ErPeris/PC/Scheda_Test_Arduino/Scheda_Test_Arduino.pdf

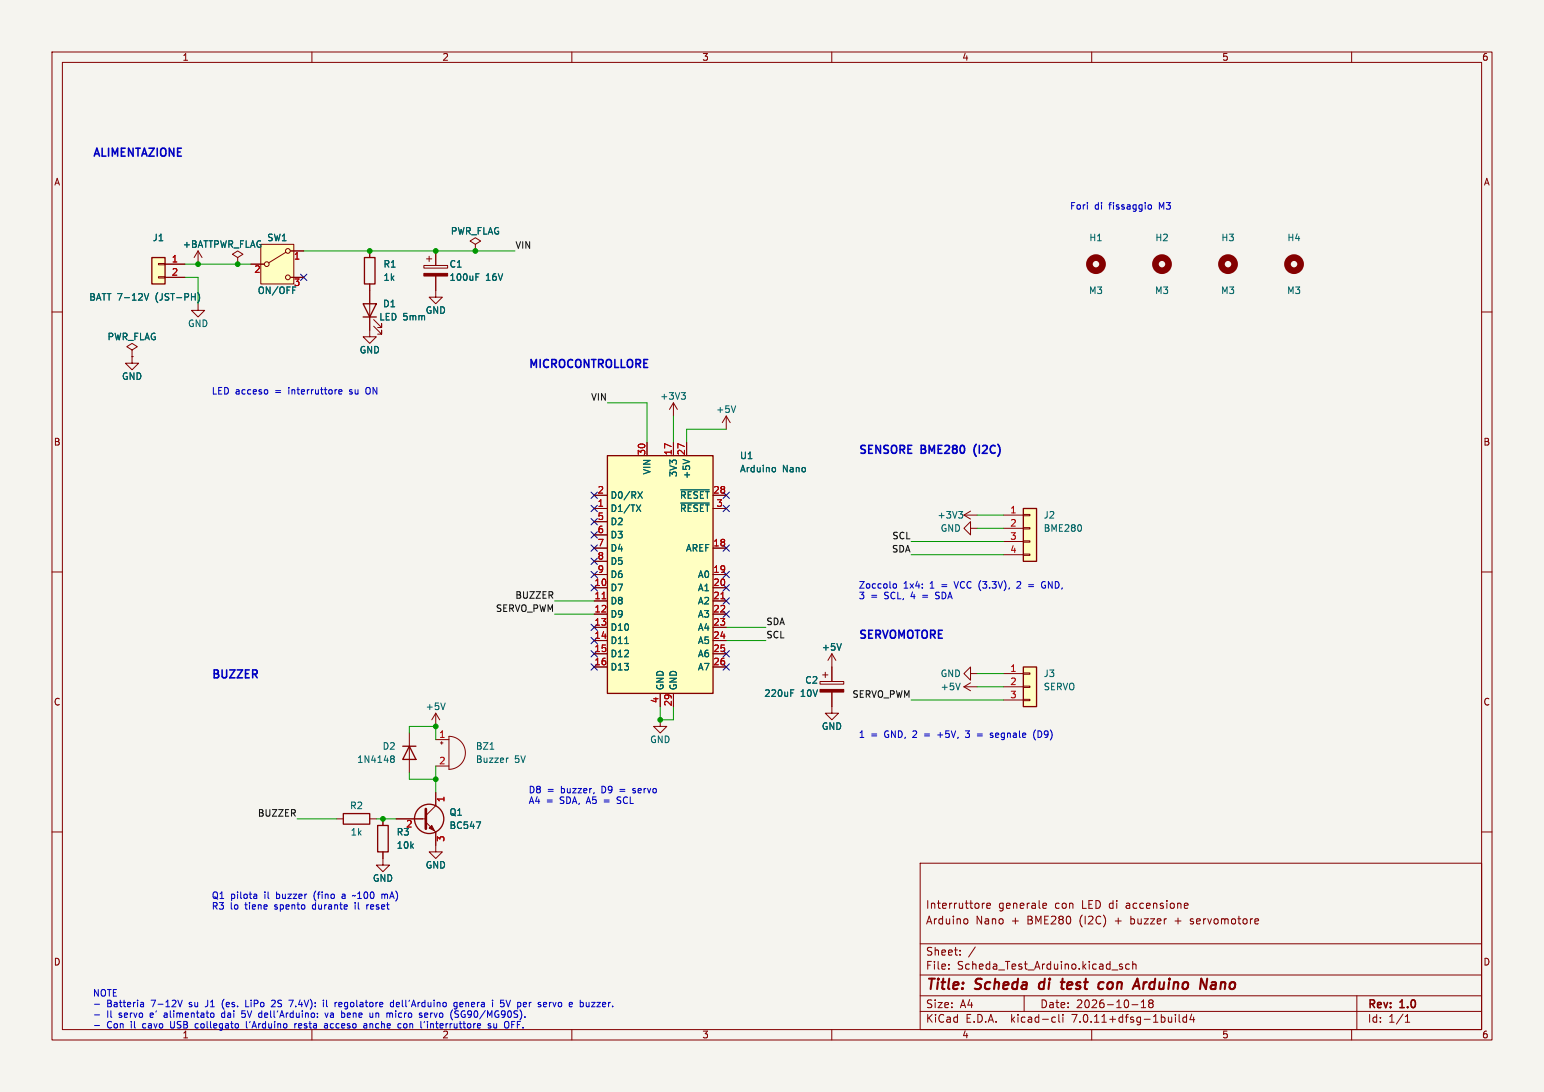
[picture p1: page 1]

Zoccolo 1x4: 1 = VCC (3.3V), 2 = GND, 3 = SCL, 4 = SDA

D8 = buzzer, D9 = servo A4 = SDA, A5 = SCL BUZZER

Q1 pilota il buzzer (fino a ~100 mA) R3 lo tiene spento durante il reset NOTE

Id: 1/1 Title: Scheda di test con Arduino Nano
