ErPeris/PC/Scheda_Test_Arduino/Scheda_Test_Arduino_PCB.pdf

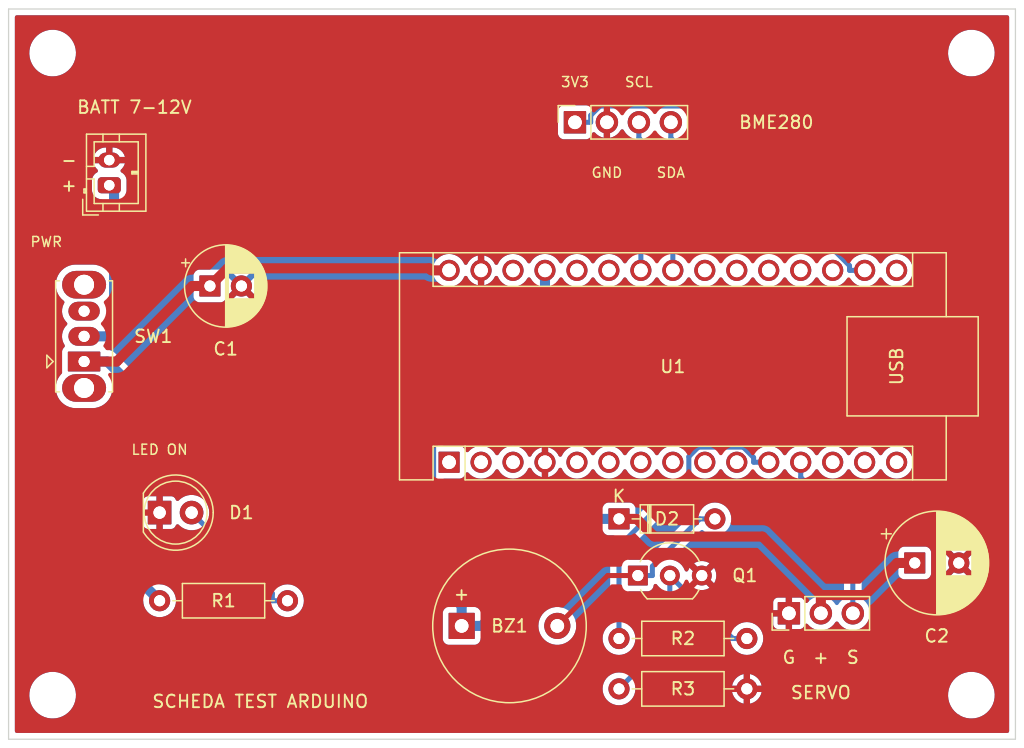
[picture p2: page 1]

SERVO SCHEDA TEST ARDUINO
