ErPeris/PC/Variante_A_LDO/Servo_Driver_A_LDO.pdf

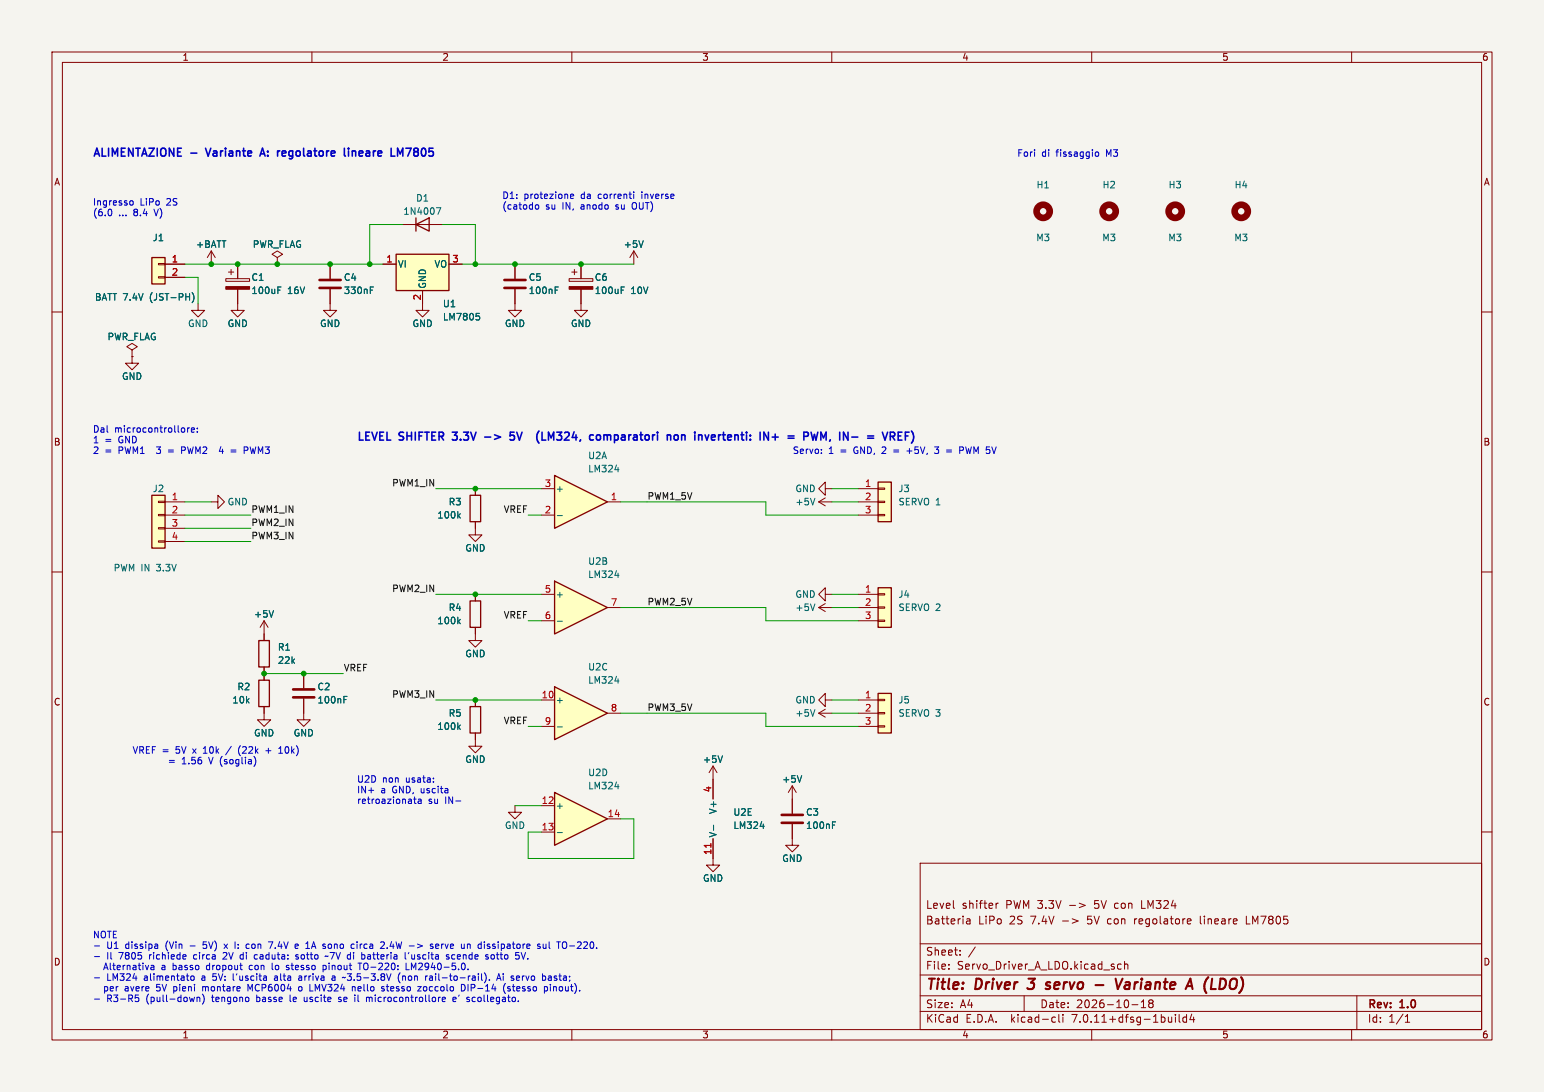
[picture p3: page 1]
