ErPeris/PC/Variante_A_LDO/Servo_Driver_A_LDO_PCB.pdf

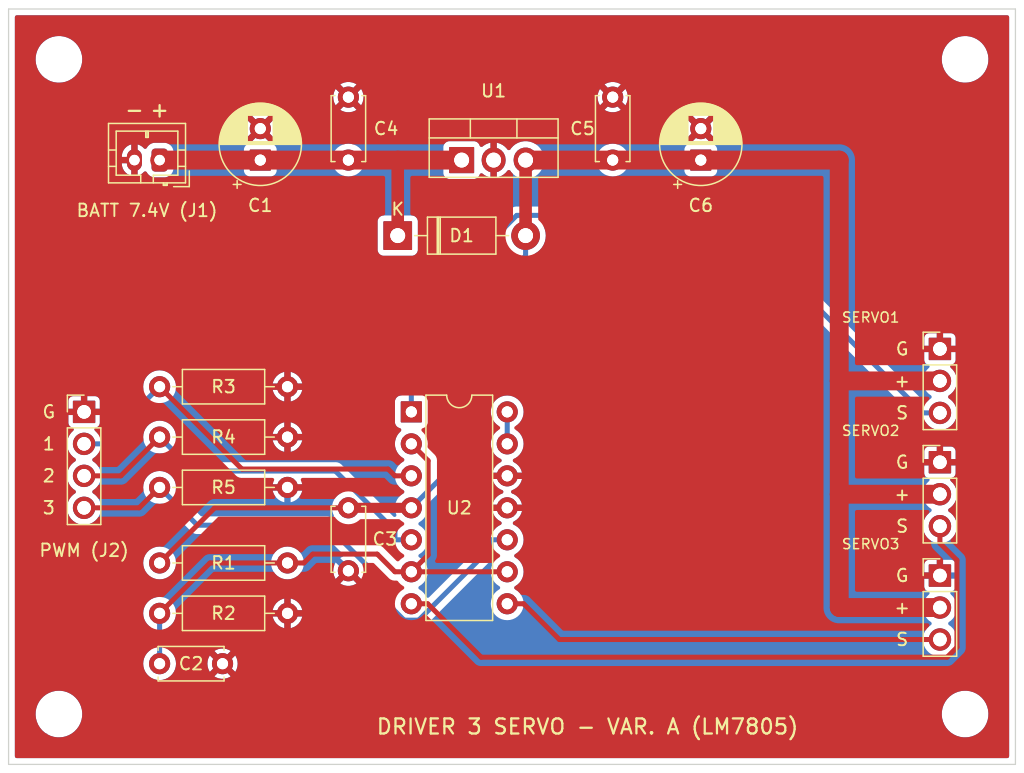
[picture p4: page 1]
