ErPeris/PC/Variante_B_Buck/Servo_Driver_B_Buck.pdf

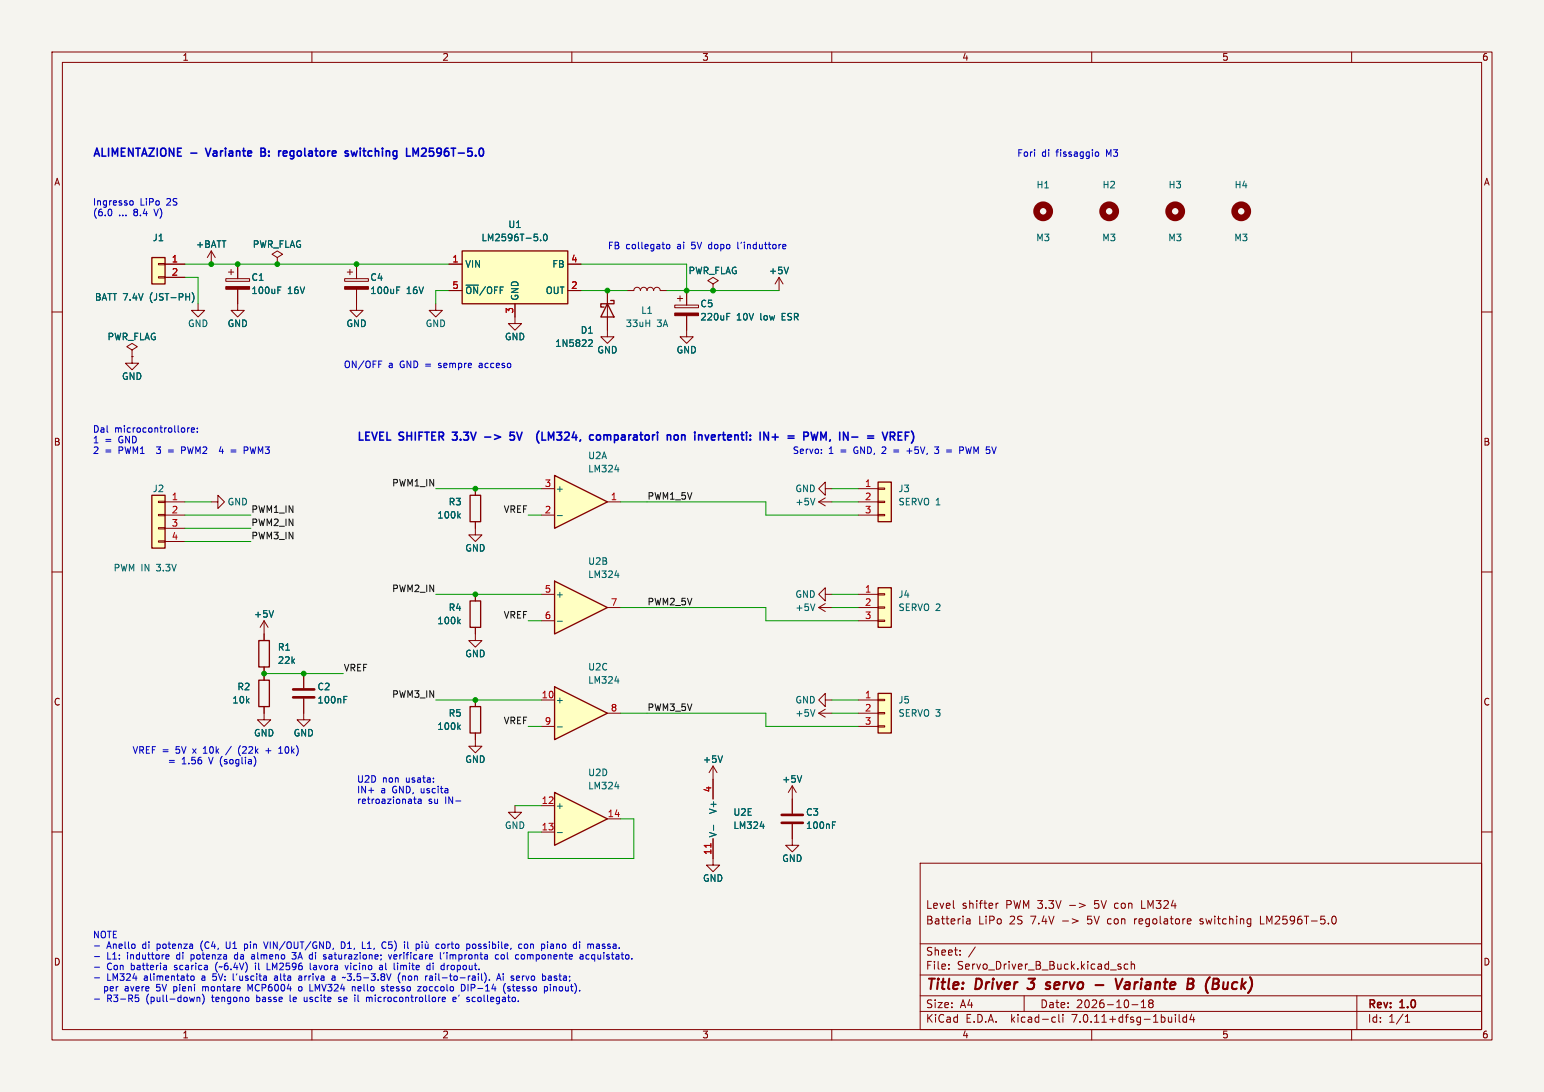
[picture p5: page 1]
