ErPeris/PC/Variante_B_Buck/Servo_Driver_B_Buck_PCB.pdf

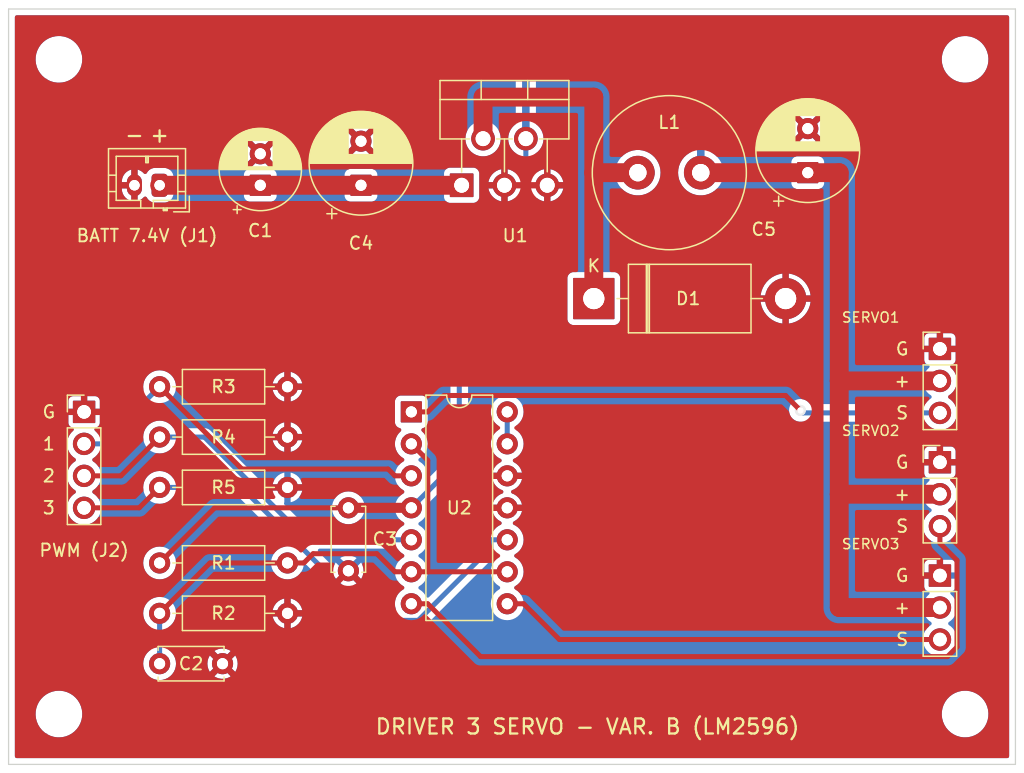
[picture p6: page 1]
