ErPeris/PC/Scheda_Test_Arduino/Scheda_Test_Arduino.kicad_pcb

## KiCad design Scheda_Test_Arduino/Scheda_Test_Arduino.kicad_pcb (2026-10-18)

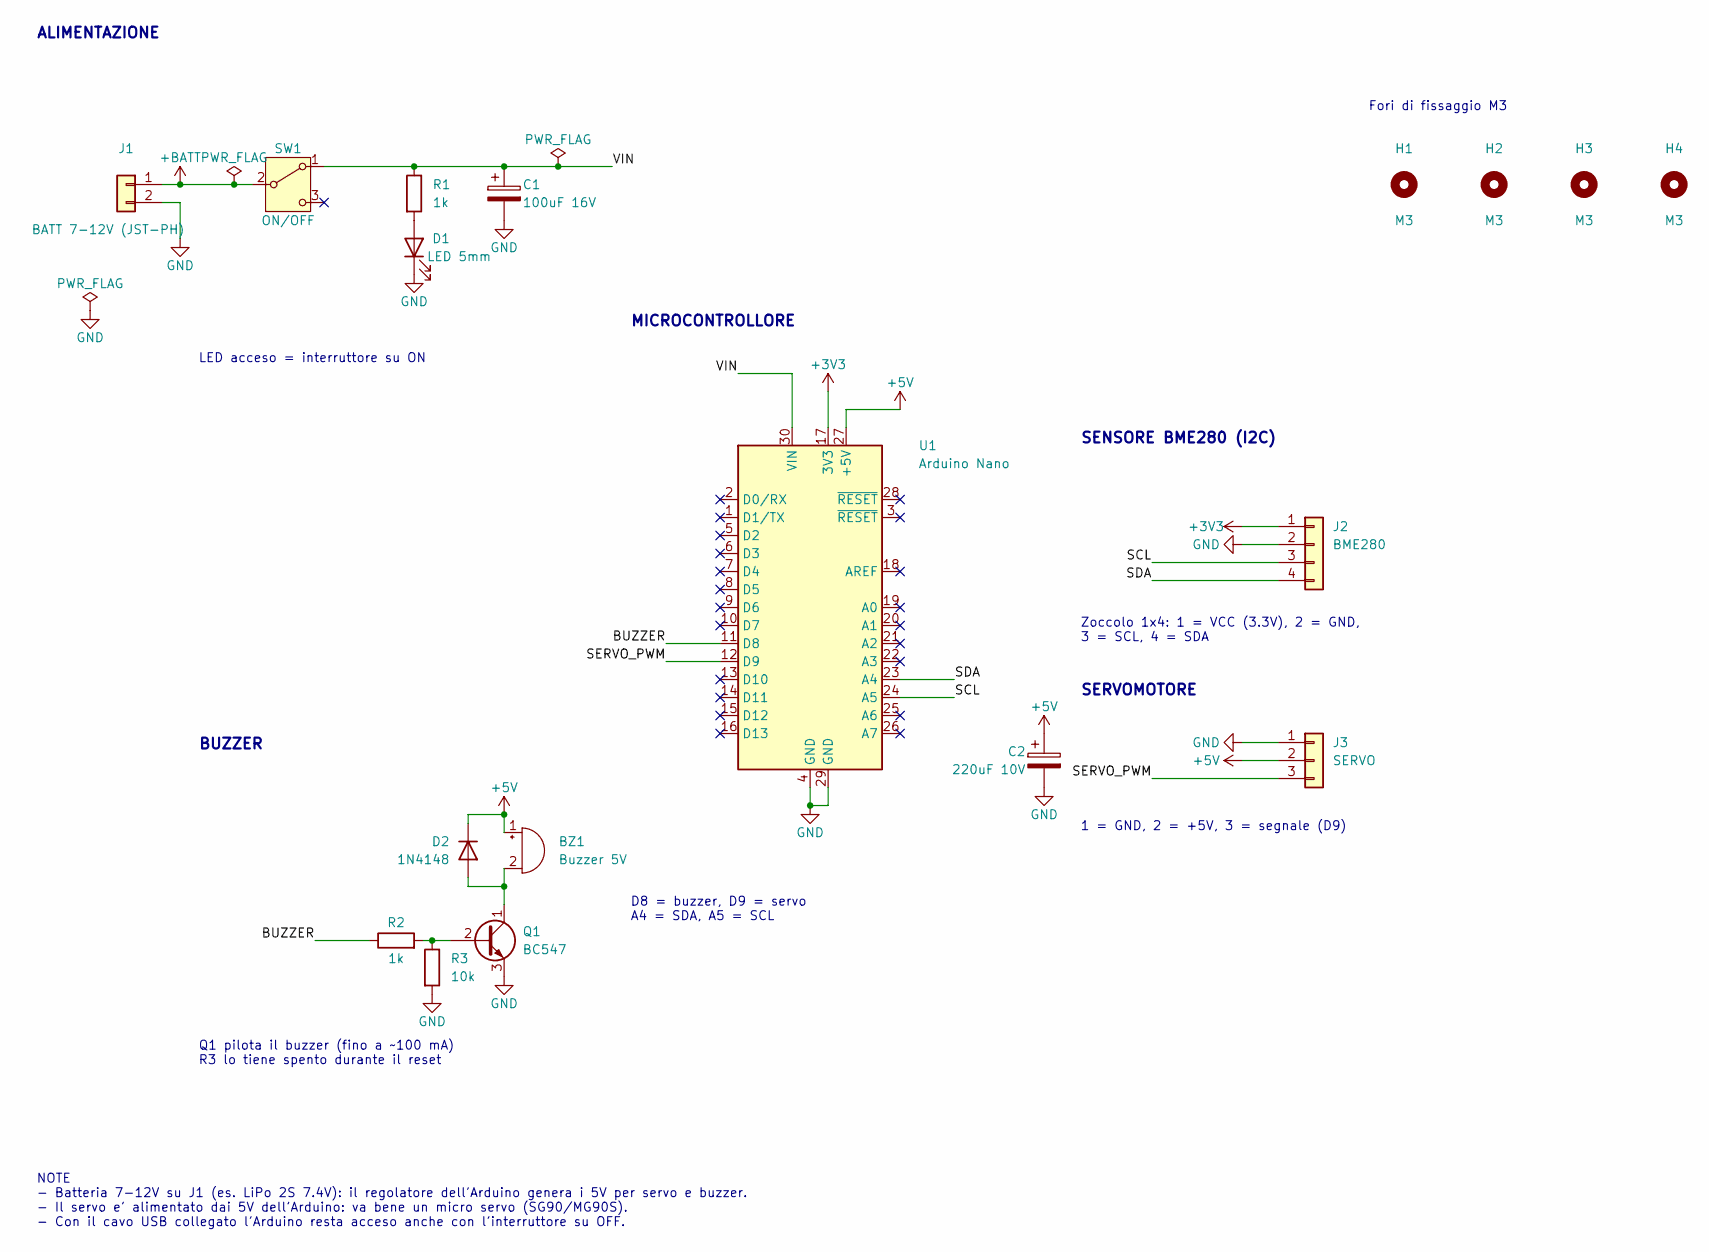
[picture p7: schematic Scheda_Test_Arduino.kicad_sch, Scheda di test con Arduino Nano]

Parts:
BZ1: Buzzer 5V; Buzzer_12x9.5RM7.6
C1: 100uF 16V; CP_Radial_D6.3mm_P2.50mm
C2: 220uF 10V; CP_Radial_D8.0mm_P3.50mm
D1: LED 5mm; LED_D5.0mm
D2: 1N4148; D_DO-35_SOD27_P7.62mm_Horizontal
H1, H2, H3, H4: M3; MountingHole_3.2mm_M3
J1: BATT 7-12V (JST-PH); JST_PH_B2B-PH-K_1x02_P2.00mm_Vertical
J2: BME280; PinSocket_1x04_P2.54mm_Vertical
J3: SERVO; PinHeader_1x03_P2.54mm_Vertical
Q1: BC547; TO-92_Inline_Wide
R1, R2: 1k; R_Axial_DIN0207_L6.3mm_D2.5mm_P10.16mm_Horizontal
R3: 10k; R_Axial_DIN0207_L6.3mm_D2.5mm_P10.16mm_Horizontal
SW1: ON/OFF; SW_Slide_SPDT_Straight_CK_OS102011MS2Q
U1: Arduino Nano; Arduino_Nano

Connections:
+3V3: J2.1, U1.17 (3V3)
+5V: BZ1.1 (+), C2.1, D2.1 (K), J3.2, U1.27 (+5V)
+BATT: J1.1, SW1.2 (B)
/BUZZER: R2.1, U1.11 (D8)
/SCL: J2.3, U1.24 (A5)
/SDA: J2.4, U1.23 (A4)
/SERVO_PWM: J3.3, U1.12 (D9)
/VIN: C1.1, R1.1, SW1.1 (A), U1.30 (VIN)
GND: C1.2, C2.2, D1.1 (K), J1.2, J2.2, J3.1, Q1.3 (E), R3.2, U1.4 (GND), U1.29 (GND)
unnamed: BZ1.2 (-), D2.2 (A), Q1.1 (C)
unnamed: D1.2 (A), R1.2
unnamed: Q1.2 (B), R2.2, R3.1

Notes on the sheet:
ALIMENTAZIONE
LED acceso = interruttore su ON
MICROCONTROLLORE
D8 = buzzer, D9 = servo A4 = SDA, A5 = SCL
SENSORE BME280 (I2C)
Zoccolo 1x4: 1 = VCC (3.3V), 2 = GND, 3 = SCL, 4 = SDA
SERVOMOTORE
1 = GND, 2 = +5V, 3 = segnale (D9)
BUZZER
Q1 pilota il buzzer (fino a ~100 mA) R3 lo tiene spento durante il reset
Fori di fissaggio M3
NOTE - Batteria 7-12V su J1 (es. LiPo 2S 7.4V): il regolatore dell'Arduino genera i 5V per servo e buzzer. - Il servo e' alimentato dai 5V dell'Arduino: va bene un micro servo (SG90/MG90S). - Con il cavo USB collegato l'Arduino resta acceso anche con l'interruttore su OFF.

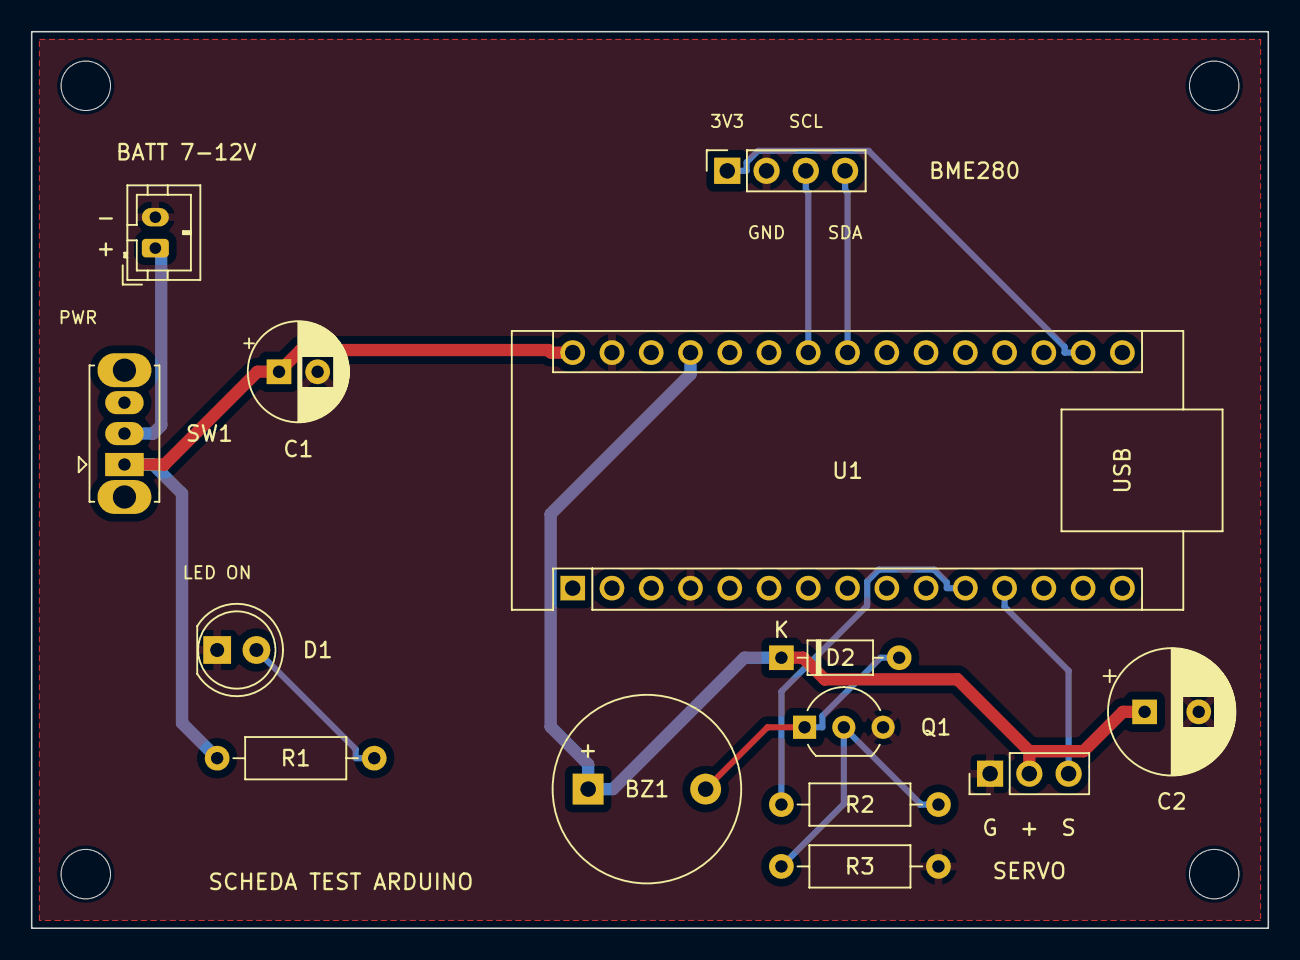
[picture p8: board Scheda_Test_Arduino.kicad_pcb from above]

Board: 2 copper layers, 80.0 x 58.0 mm, 18 parts (0 on the bottom side), 12 nets.
