ErPeris/PC/Variante_A_LDO/Servo_Driver_A_LDO.kicad_pcb

## KiCad design Variante_A_LDO/Servo_Driver_A_LDO.kicad_pcb (2026-10-18)

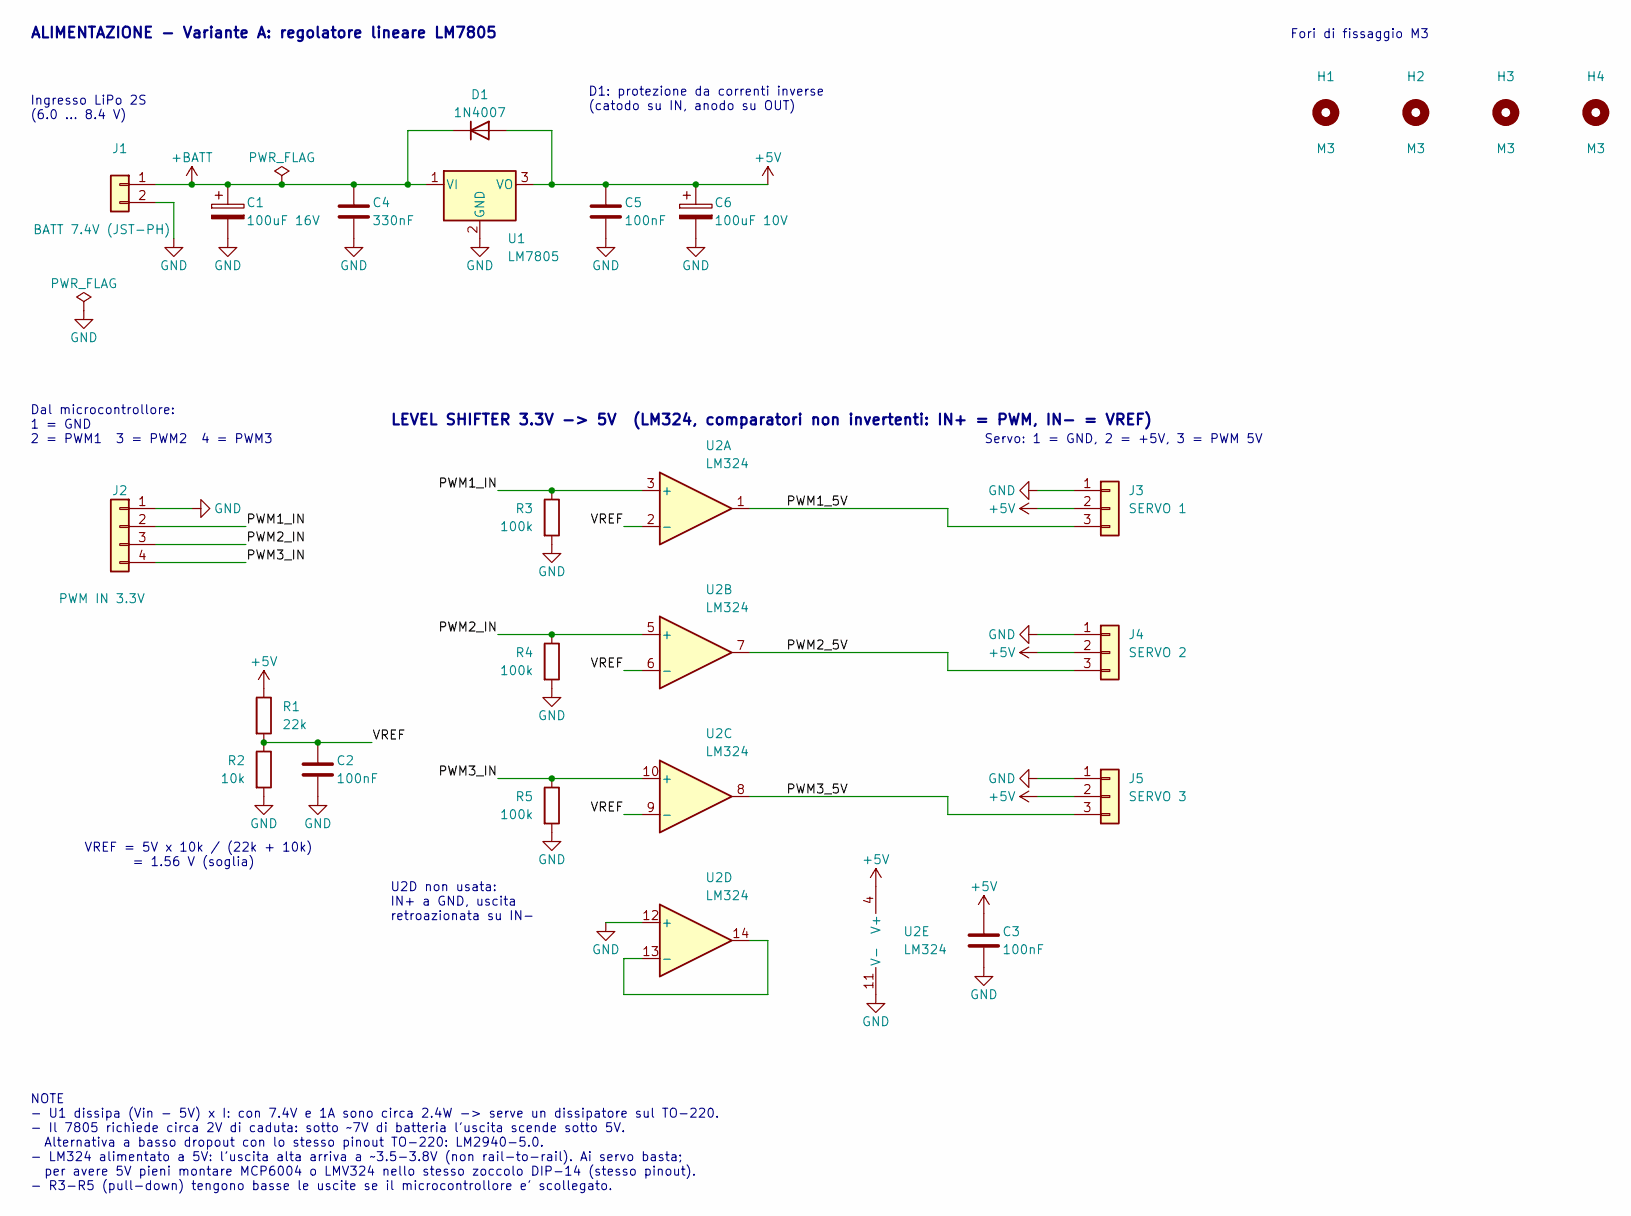
[picture p9: schematic Servo_Driver_A_LDO.kicad_sch, Driver 3 servo - Variante A (LDO)]

Parts:
C1: 100uF 16V; CP_Radial_D6.3mm_P2.50mm
C2, C3, C5: 100nF; C_Disc_D5.0mm_W2.5mm_P5.00mm
C4: 330nF; C_Disc_D5.0mm_W2.5mm_P5.00mm
C6: 100uF 10V; CP_Radial_D6.3mm_P2.50mm
D1: 1N4007; D_DO-41_SOD81_P10.16mm_Horizontal
H1, H2, H3, H4: M3; MountingHole_3.2mm_M3
J1: BATT 7.4V (JST-PH); JST_PH_B2B-PH-K_1x02_P2.00mm_Vertical
J2: PWM IN 3.3V; PinHeader_1x04_P2.54mm_Vertical
J3: SERVO 1; PinHeader_1x03_P2.54mm_Vertical
J4: SERVO 2; PinHeader_1x03_P2.54mm_Vertical
J5: SERVO 3; PinHeader_1x03_P2.54mm_Vertical
R1: 22k; R_Axial_DIN0207_L6.3mm_D2.5mm_P10.16mm_Horizontal
R2: 10k; R_Axial_DIN0207_L6.3mm_D2.5mm_P10.16mm_Horizontal
R3, R4, R5: 100k; R_Axial_DIN0207_L6.3mm_D2.5mm_P10.16mm_Horizontal
U1: LM7805; TO-220-3_Vertical
U2: LM324; DIP-14_W7.62mm

Connections:
+5V: C3.1, C5.1, C6.1, D1.2 (A), J3.2, J4.2, J5.2, R1.1, U1.3 (VO), U2.4 (V+)
+BATT: C1.1, C4.1, D1.1 (K), J1.1, U1.1 (VI)
/PWM1_5V: J3.3, U2.1
/PWM1_IN: J2.2, R3.1, U2.3 (+)
/PWM2_5V: J4.3, U2.7
/PWM2_IN: J2.3, R4.1, U2.5 (+)
/PWM3_5V: J5.3, U2.8
/PWM3_IN: J2.4, R5.1, U2.10 (+)
/VREF: C2.1, R1.2, R2.1, U2.2 (-), U2.6 (-), U2.9 (-)
GND: C1.2, C2.2, C3.2, C4.2, C5.2, C6.2, J1.2, J2.1, J3.1, J4.1, J5.1, R2.2, R3.2, R4.2, R5.2, U1.2 (GND), U2.11 (V-), U2.12 (+)
unnamed: U2.13 (-), U2.14

Notes on the sheet:
ALIMENTAZIONE - Variante A: regolatore lineare LM7805
Ingresso LiPo 2S (6.0 ... 8.4 V)
D1: protezione da correnti inverse (catodo su IN, anodo su OUT)
Dal microcontrollore: 1 = GND 2 = PWM1 3 = PWM2 4 = PWM3
VREF = 5V x 10k / (22k + 10k) = 1.56 V (soglia)
Servo: 1 = GND, 2 = +5V, 3 = PWM 5V
U2D non usata: IN+ a GND, uscita retroazionata su IN-
Fori di fissaggio M3
LEVEL SHIFTER 3.3V -> 5V (LM324, comparatori non invertenti: IN+ = PWM, IN- = VREF)
NOTE - U1 dissipa (Vin - 5V) x I: con 7.4V e 1A sono circa 2.4W -> serve un dissipatore sul TO-220. - Il 7805 richiede circa 2V di caduta: sotto ~7V di batteria l'uscita scende sotto 5V. Alternativa a basso dropout con lo stesso pinout TO-220: LM2940-5.0. - LM324 alimentato a 5V: l'uscita alta arri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

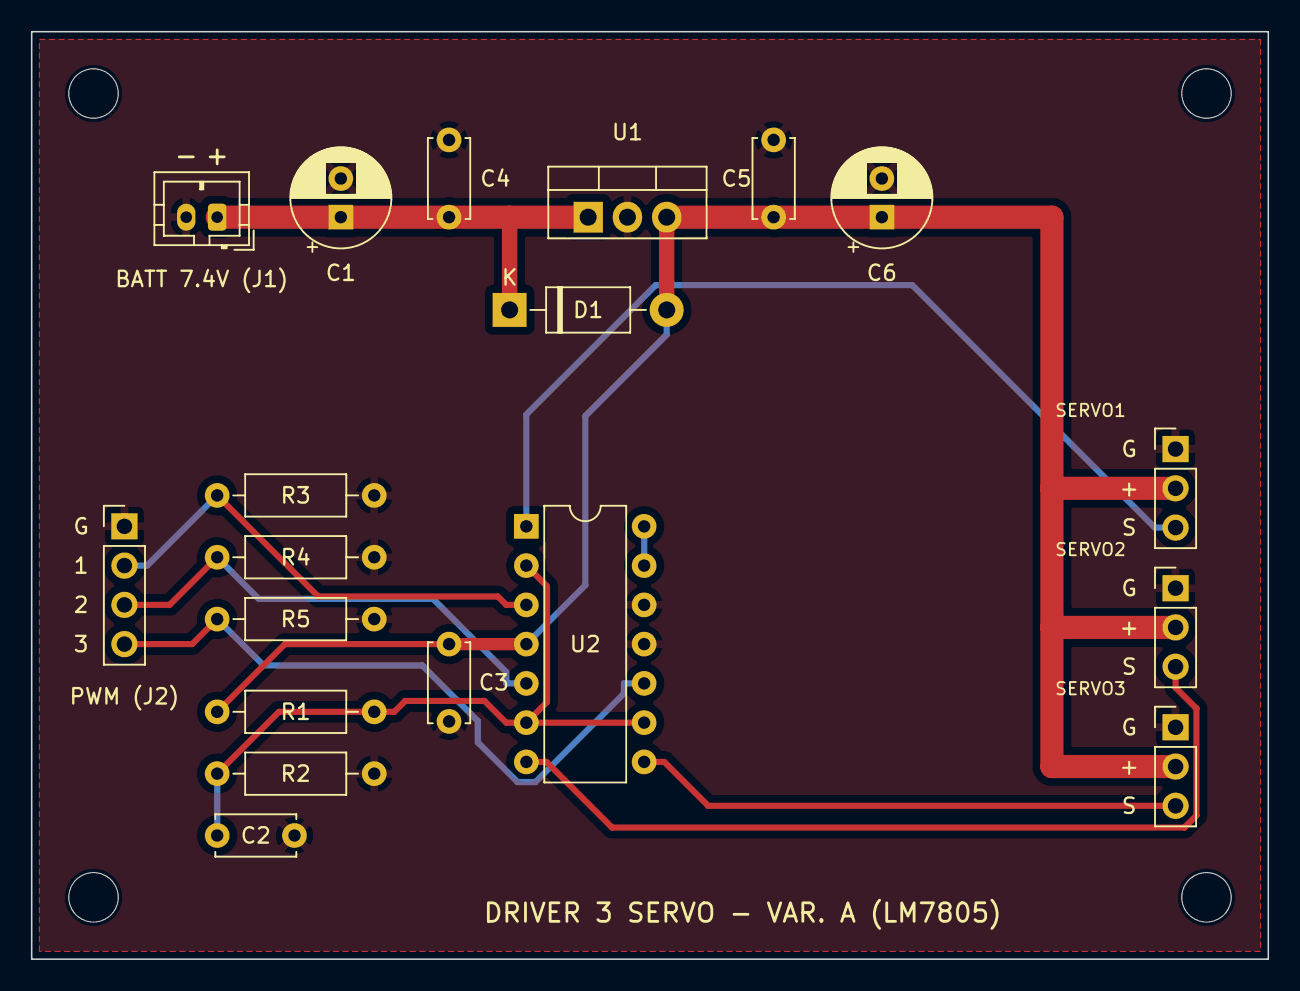
[picture p10: board Servo_Driver_A_LDO.kicad_pcb from above]

Board: 2 copper layers, 80.0 x 60.0 mm, 23 parts (0 on the bottom side), 11 nets.
