ErPeris/PC/(commit log)

2026-10-18 Driver 3 servo: schemi KiCad variante A (LM7805) e B (LM2596S-5.0)
    Due progetti KiCad con schema completo e impronte assegnate, PDF di
    anteprima, README con distinta componenti e note di progetto, script di
    generazione e di verifica della netlist.
    Claude-Session: https://claude.ai/code/session_01B5RPuFFwz1raQxdy9coUUD
    [Servo_Driver_A_LDO.kicad_sch, Servo_Driver_B_Buck.kicad_sch]
2026-10-18 PCB a foro passante per entrambe le varianti
    - Variante B: LM2596T-5.0 (TO-220-5) al posto della versione SMD
    - Fori di fissaggio M3 nello schema
    - PCB 80x60 mm a 2 strati: piste di potenza da 1.5 mm, piano di massa
    su entrambe le facce, segnali sbrogliati con Freerouting; DRC pulito
    - UUID deterministici, così schema e PCB restano collegati
    - README aggiornato
    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
    [Servo_Driver_A_LDO.kicad_pcb, Servo_Driver_A_LDO.kicad_sch, Servo_Driver_B_Buck.kicad_pcb, Servo_Driver_B_Buck.kicad_sch]
2026-10-18 Gerber, forature e pacchetti zip per la produzione
    - Gerber (rame, maschera, serigrafia, contorno) e forature Excellon
    PTH/NPTH per entrambe le varianti
    - produzione/: zip Gerber da caricare dal produttore e zip del
    progetto KiCad completo
    - README: dati per l'ordine e come rigenerare i Gerber
    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
    [Servo_Driver_A_LDO-B_Cu.gbl, Servo_Driver_A_LDO-B_Mask.gbs, Servo_Driver_A_LDO-B_Silkscreen.gbo, Servo_Driver_A_LDO-Edge_Cuts.gm1, Servo_Driver_A_LDO-F_Cu.gtl, Servo_Driver_A_LDO-F_Mask.gts, Servo_Driver_A_LDO-F_Silkscreen.gto, Servo_Driver_A_LDO-NPTH.drl]
2026-10-18 Scheda di test con Arduino Nano: schema, PCB, Gerber e sketch di prova
    - Arduino Nano con BME280 (I2C), buzzer pilotato da BC547, servo su D9,
    interruttore generale e LED di accensione
    - PCB 80x58 mm a 2 strati, foro passante, piano di massa; DRC pulito
    - Gerber, forature e zip del progetto in produzione/
    - genera_pcb.py riusabile per più schede; l'esportazione verso
    Freerouting avviene in un processo separato perché KiCad 7 riusa il
    progetto in cache e ignora le classi di net
    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
    [Scheda_Test_Arduino-B_Cu.gbl, Scheda_Test_Arduino-B_Mask.gbs, Scheda_Test_Arduino-B_Silkscreen.gbo, Scheda_Test_Arduino-Edge_Cuts.gm1, Scheda_Test_Arduino-F_Cu.gtl, Scheda_Test_Arduino-F_Mask.gts, Scheda_Test_Arduino-F_Silkscreen.gto, Scheda_Test_Arduino-NPTH.drl]
